shufps/iota_vhdl_pow/pcb/rev1.3/rev1.3.jpg

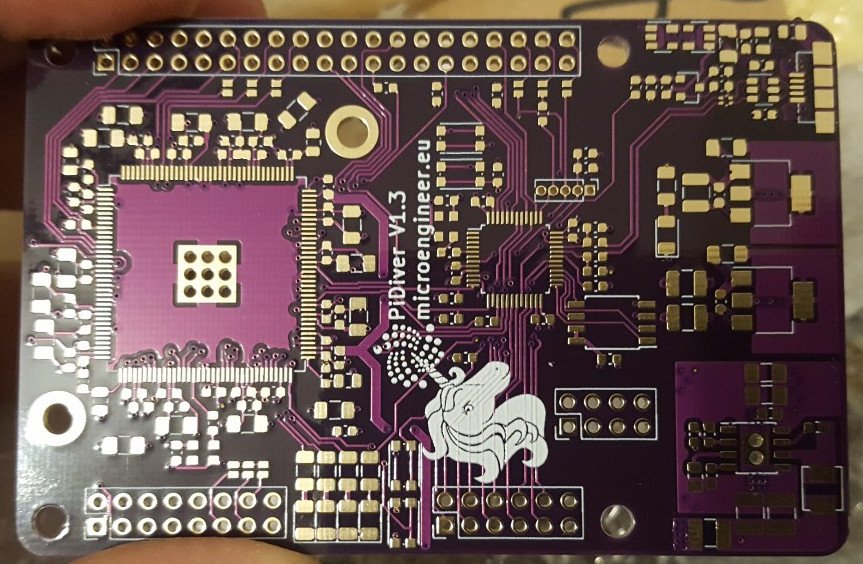
pcb/rev1.3/rev1.3.jpg
