shufps/iota_vhdl_pow/README.md

# IOTA VHDL PoW (Pearl Diver)

Project moved to:

https://gitlab.com/microengineer18/pidiver1.3/wikis/home
