shufps/iota_vhdl_pow/pcb/README.md

Files not suitable for machine assembly!
Board files are outdated ... New files with many improvements coming #soon
