shufps/iota_vhdl_pow/pcb/rev1.3/bom_mouser.xls

PIDIVER 1.3
Mouser-Nr. | Herst.- Nr. | Hersteller | Kunden-Teilenr | Beschreibung | RoHS | Lebenszyklus | Stückzahl | Preis (EUR) | Gesamtpreis: (EUR)
989-10CL025YE144I7G | 10CL025YE144I7G | Intel |  | FPGA – Universalschaltkreis | RoHS-konform | Neues Produkt | 1 | 23,21 € | 23,21 €
700-MAX40200AUK+T | MAX40200AUK+T | Maxim Integrated |  | Überwachungsschaltungen Current Sense/Ideal Diode | RoHS-konform | Neues Produkt | 2 | 0,553 € | 1,11 €
511-LD1117S33 | LD1117S33TR | STMicroelectronics |  | LDO Spannungs-Regulator 3.3V 0.8A Positive | RoHS-konform |  | 1 | 0,349 € | 0,35 €
755-BD9D321EFJ-E2 | BD9D321EFJ-E2 | ROHM Semiconductor |  | Schaltspannungsregler IC Pwr Swtch Reg Integrated FET | RoHS-konform |  | 1 | 0,621 € | 0,62 €
511-LDL1117S25R | LDL1117S25R | STMicroelectronics |  | LDO Spannungs-Regulator | RoHS-konform | Neues Produkt | 1 | 0,374 € | 0,37 €
511-STM32F302CCT6TR | STM32F302CCT6TR | STMicroelectronics |  | ARM Mikrocontroller - MCU Mainstream Mixed signals MCUs ARM Cortex-M4 core with DSP and FPU, 256 Kbytes Flash, 72 MHz CPU, MPU, 12-bit ADC 5 MSPS, PGA, comparators |  | Neues Produkt | 1 | 5,32 € | 5,32 €
511-USBLC6-2SC6Y | USBLC6-2SC6Y | STMicroelectronics |  | ESD-Entstörer/TVS-Dioden 2 Line 2.5pF 10nA USB 2.0 Automotive | RoHS-konform |  | 1 | 0,621 € | 0,62 €
611-KMR223GLFG | KMR223GLFG | C&K Switches |  | Sensorschalter Spst-No 200Gf Gw Smd | RoHS-konform |  | 4 | 0,561 € | 2,24 €
649-10104110-0001LF | 10104110-0001LF | FCI / Amphenol |  | USB-Stecker 5P Quick Connect Micro USB TypeB Rcpt | RoHS-konform |  | 1 | 0,646 € | 0,65 €
710-74279220181 | 74279220181 | Wurth Electronics |  | Ferritperlen WE-MPSB Bead 0805 100MHz 180Ohm 3100mA | RoHS-konform |  | 6 | 0,29 € | 1,74 €
81-DLP11SA900HL2L | DLP11SA900HL2L | Murata |  | Gleichtaktdrosseln / Filter 90Ohm 20% 100MHz | RoHS-konform |  | 1 | 0,468 € | 0,47 €
810-SPM4012T-2R2MT | SPM4012T-2R2M T | TDK |  | Festinduktivitäten 2.2uH 95mohms 3.3A +/-20% | RoHS-konform |  | 1 | 1,28 € | 1,28 €
581-KC3225A8.C3GE | KC3225A8.00000C3GE00 | Kyocera |  | Clock-Standardoszillatoren 8.00000MHZ 3.3V | RoHS-konform |  | 2 | 1,32 € | 2,64 €
579-25VF080B504IS2AE | SST25VF080B-50-4I-S2AE | Microchip |  | NOR-Flash 2.7V to 3.6V 8Mbit SPI Serial Flash | RoHS-konform |  | 1 | 0,876 € | 0,88 €
603-CC603MRX7R7BB104 | CC0603MRX7R7BB104 | Yageo |  | Kondensator aus mehreren Keramikschichten MLCC - SMD/SMT 100nF 16V X7R 20% | RoHS: Konform durch Ausnahmegenehmigung |  | 47 | 0,033 € | 1,55 €
710-885012206014 | 885012206014 | Wurth Electronics |  | Kondensator aus mehreren Keramikschichten MLCC - SMD/SMT WCAP-CSGP 0.01uF 0603 10% 10V MLCC | RoHS-konform |  | 1 | 0,04 € | 0,04 €
710-885012206086 | 885012206086 | Wurth Electronics |  | Kondensator aus mehreren Keramikschichten MLCC - SMD/SMT WCAP-CSGP 3300pF 0603 10% 50V MLCC | RoHS-konform |  | 1 | 0,04 € | 0,04 €
710-885012006021 | 885012006021 | Wurth Electronics |  | Kondensator aus mehreren Keramikschichten MLCC - SMD/SMT WCAP-CSGP 47pF 0603 5% 16V MLCC | RoHS-konform |  | 2 | 0,07 € | 0,14 €
81-GRM21BR61C105KA1K | GRM21BR61C105KA01K | Murata |  | Kondensator aus mehreren Keramikschichten MLCC - SMD/SMT | RoHS-konform |  | 1 | 0,145 € | 0,15 €
77-VJ1206G106KXYTBC | VJ1206G106KXYTW1BC | Vishay |  | Kondensator aus mehreren Keramikschichten MLCC - SMD/SMT 1206 10uF 6.3volts X5R 10% | RoHS-konform |  | 14 | 0,128 € | 1,79 €
963-TMK316BJ475ML-T | TMK316BJ475ML-T | Taiyo Yuden |  | Kondensator aus mehreren Keramikschichten MLCC - SMD/SMT FACTORY NOT ACCEPTING ORDERS | RoHS-konform |  | 2 | 0,247 € | 0,49 €
581-12064D476MAT2A | 12064D476MAT2A | AVX |  | Kondensator aus mehreren Keramikschichten MLCC - SMD/SMT FACTORY NOT ACCEPTING ORDERS | RoHS-konform |  | 4 | 0,748 € | 2,99 €
810-C3225X5R1A476M | C3225X5R1A476M250AC | TDK |  | Kondensator aus mehreren Keramikschichten MLCC - SMD/SMT 1210 10V 47uF X5R 20% T: 2.5mm | RoHS-konform |  | 5 | 1,07 € | 5,35 €
603-AC0603FR-0722RL | AC0603FR-0722RL | Yageo |  | Dickfilmwiderstände - SMD 1/10W 22ohm 1% AEC-Q200 | RoHS: Konform durch Ausnahmegenehmigung |  | 5 | 0,085 € | 0,43 €
603-RC0603FR-0733RL | RC0603FR-0733RL | Yageo |  | Dickfilmwiderstände - SMD 33 OHM 1% | RoHS-konform |  | 2 | 0,085 € | 0,17 €
603-RC0603FR-07100KL | RC0603FR-07100KL | Yageo |  | Dickfilmwiderstände - SMD 100K OHM 1% | RoHS-konform |  | 1 | 0,085 € | 0,09 €
756-GWCR0603-10KFT5 | GWCR0603-10KFT5 | TT Electronics |  | Dickfilmwiderstände - SMD 1/10W 10K Ohm 1% | RoHS-konform | Neues Produkt | 10 | 0,085 € | 0,85 €
603-RC0603FR-071K5L | RC0603FR-071K5L | Yageo |  | Dickfilmwiderstände - SMD 1.5K OHM 1% | RoHS-konform |  | 1 | 0,085 € | 0,09 €
279-CPF0603B12K7E1 | CPF0603B12K7E1 | TE Connectivity |  | Dünnfilmwiderstände - SMD CPF 0603 12K7 0.1% 25PPM 1K RL | RoHS-konform |  | 1 | 0,17 € | 0,17 €
279-CPF0603B22KE1 | CPF0603B22KE1 | TE Connectivity |  | Dünnfilmwiderstände - SMD CPF 0603 22K 0.1% 25PPM 1K RL | RoHS-konform |  | 1 | 0,264 € | 0,26 €
603-RT1206FRE07270RL | RT1206FRE07270RL | Yageo |  | Dünnfilmwiderstände - SMD 1/4W 270 ohm 1% 50ppm | RoHS: Konform durch Ausnahmegenehmigung |  | 5 | 0,162 € | 0,81 €
710-150120RS75000 | 150120RS75000 | Wurth Electronics |  | Standard-LEDs - SMD WL-SMCW SMDMono TpVw Waterclr 1206 Red | RoHS-konform |  | 5 | 0,19 € | 0,95 €
984-CPX02502-137C2R0 | ATS-CPX025025010-137-C2-R0 | Advanced Thermal Solutions |  | Wärmeableitungen PUSHPIN H/S BLUE 25X25X10.0mm | RoHS-konform | Neu bei Mouser | 1 | 2,98 € | 2,98 €
984-ATS-PP-01 | ATS-PP-01 | Advanced Thermal Solutions |  | Wärmeableitungen MUSIC WIRE COIL SPRING | RoHS-konform | Neu bei Mouser | 2 | 0,825 € | 1,65 €
984-ATS-PPS-02 | ATS-PPS-02 | Advanced Thermal Solutions |  | Wärmeableitungen MUSIC WIRE COIL SPRING | RoHS-konform | Neu bei Mouser | 2 | 0,17 € | 0,34 €
