shufps/iota_vhdl_pow/(threads)

Thread 3 (2018-09-17):

version confusion

gitrago, 2018-09-17:
Do the Gerber files in`iota_vhdl_pow/pcb/rev1.0/kicad/pearldiver/gerber/` correspond with the BOM in `iota_vhdl_pow/pcb/rev1.2/`?

Thread 4 (2018-09-18):

Follow-up to Q 'version confusion'

gitrago, 2018-09-18:
Do you plan to publish the gerbers for v1.2 and v1.3? If so, when? If not, then what is the point in publishing the BOMs?

shufps, 2018-09-18:
Gerbers for v1.3 will be published - but not now. Currently I'm hoping to get funded from the ecosystem which would allow me to manufactur and sell PiDivers. Not releasing the gerbers currently is to protect my work - I would like to get the chance to manufactur them before someone else uses my files. But I don't know (yet) when and if I it gets funded.

Released BOM-files are for people who want to assemble PiDivers by themselves. Some people got PCBs from me - for beta-testers so to say. :)

shufps, 2018-09-18:
By the way, rev1.0 still is supported and fully functional. It has some features less than newer revisions, but it can do PoW with Raspberry or USB.

Some changes:
rev1.1: another STM32 micro which has a default bootloader for flashing; Automatic switch of USB-power and GPIO-power was tested (but didn't work)
rev1.2: automatic switching works. It also got a pinheader for spare pins from the FPGA
rev1.3: default bootload is simpler to access with push-buttons. Additional pinheader for unused pins from the STM32.

But the PoW over Raspi or USB didn't change much - both work fine in rev1.0.
