shufps/iota_vhdl_pow/pcb/rev1.3/pearldiver-F.Fab.pdf

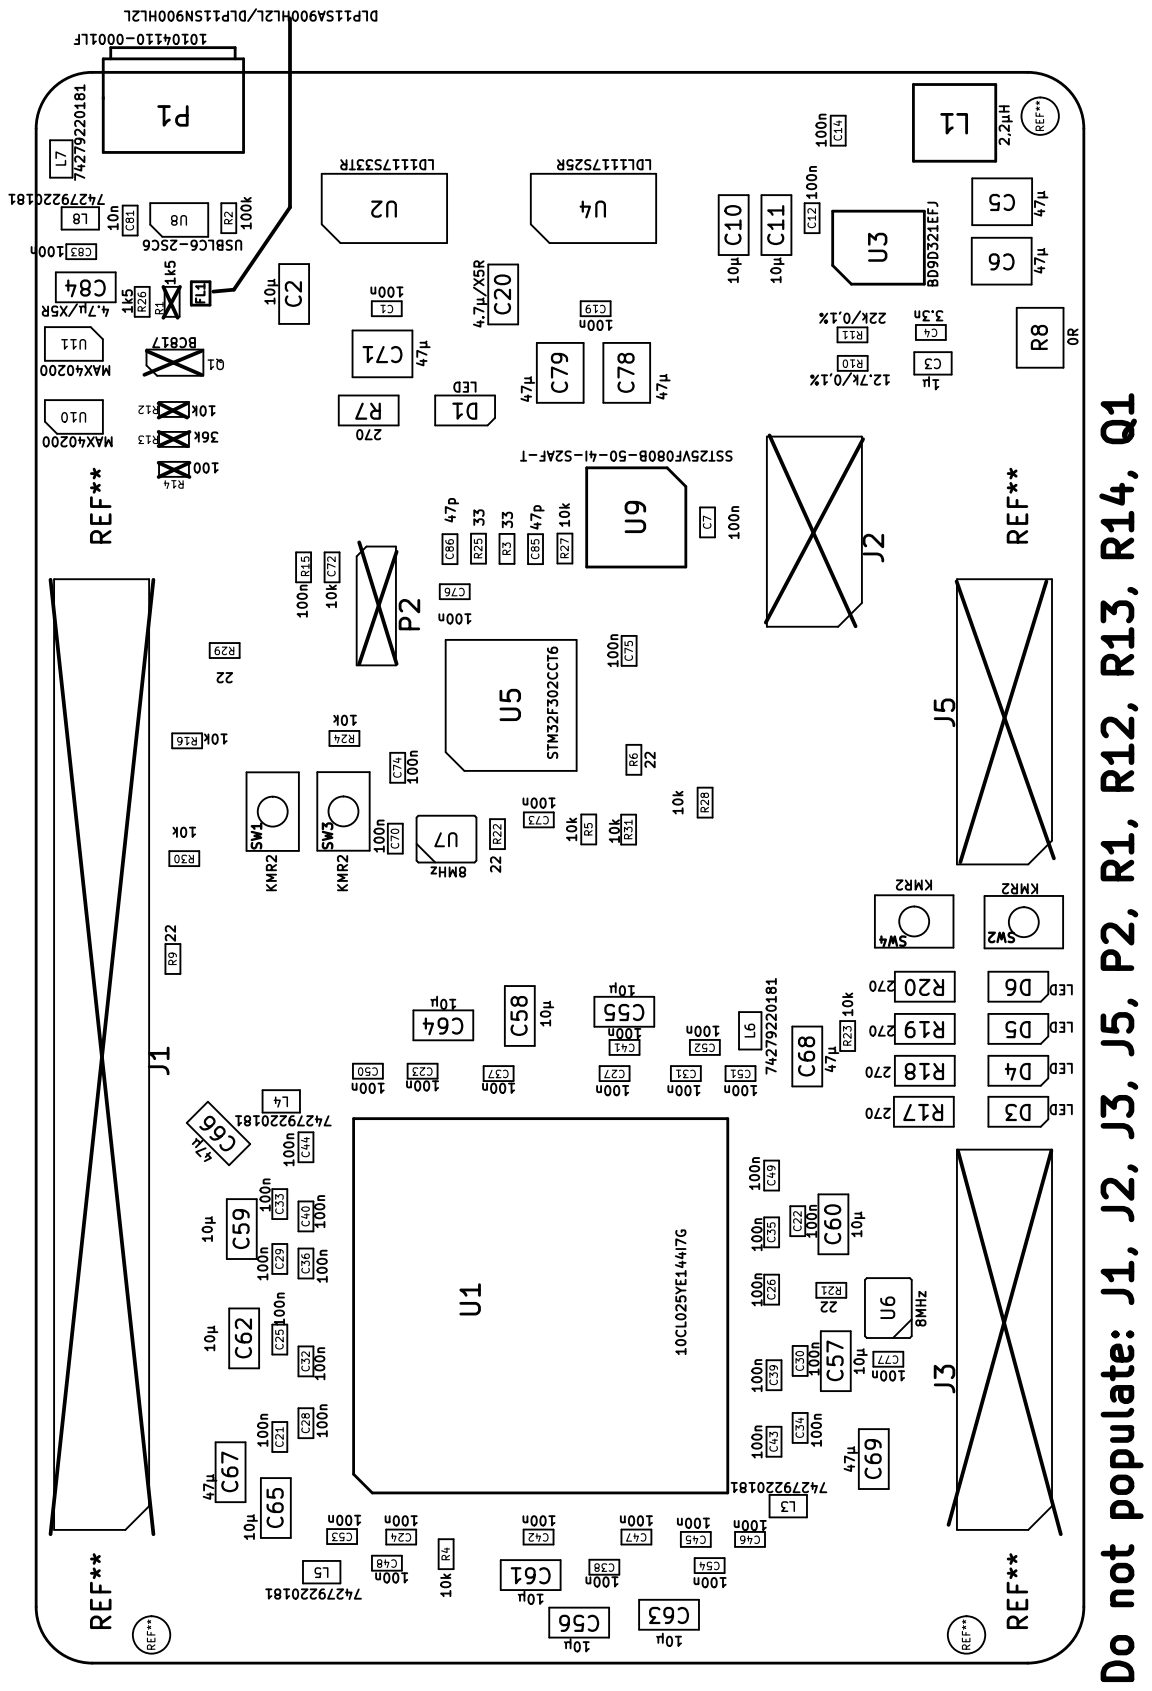
[picture p2: page 1]
