shufps/iota_vhdl_pow/pcb/rev1.0/pearldiver-front.pdf

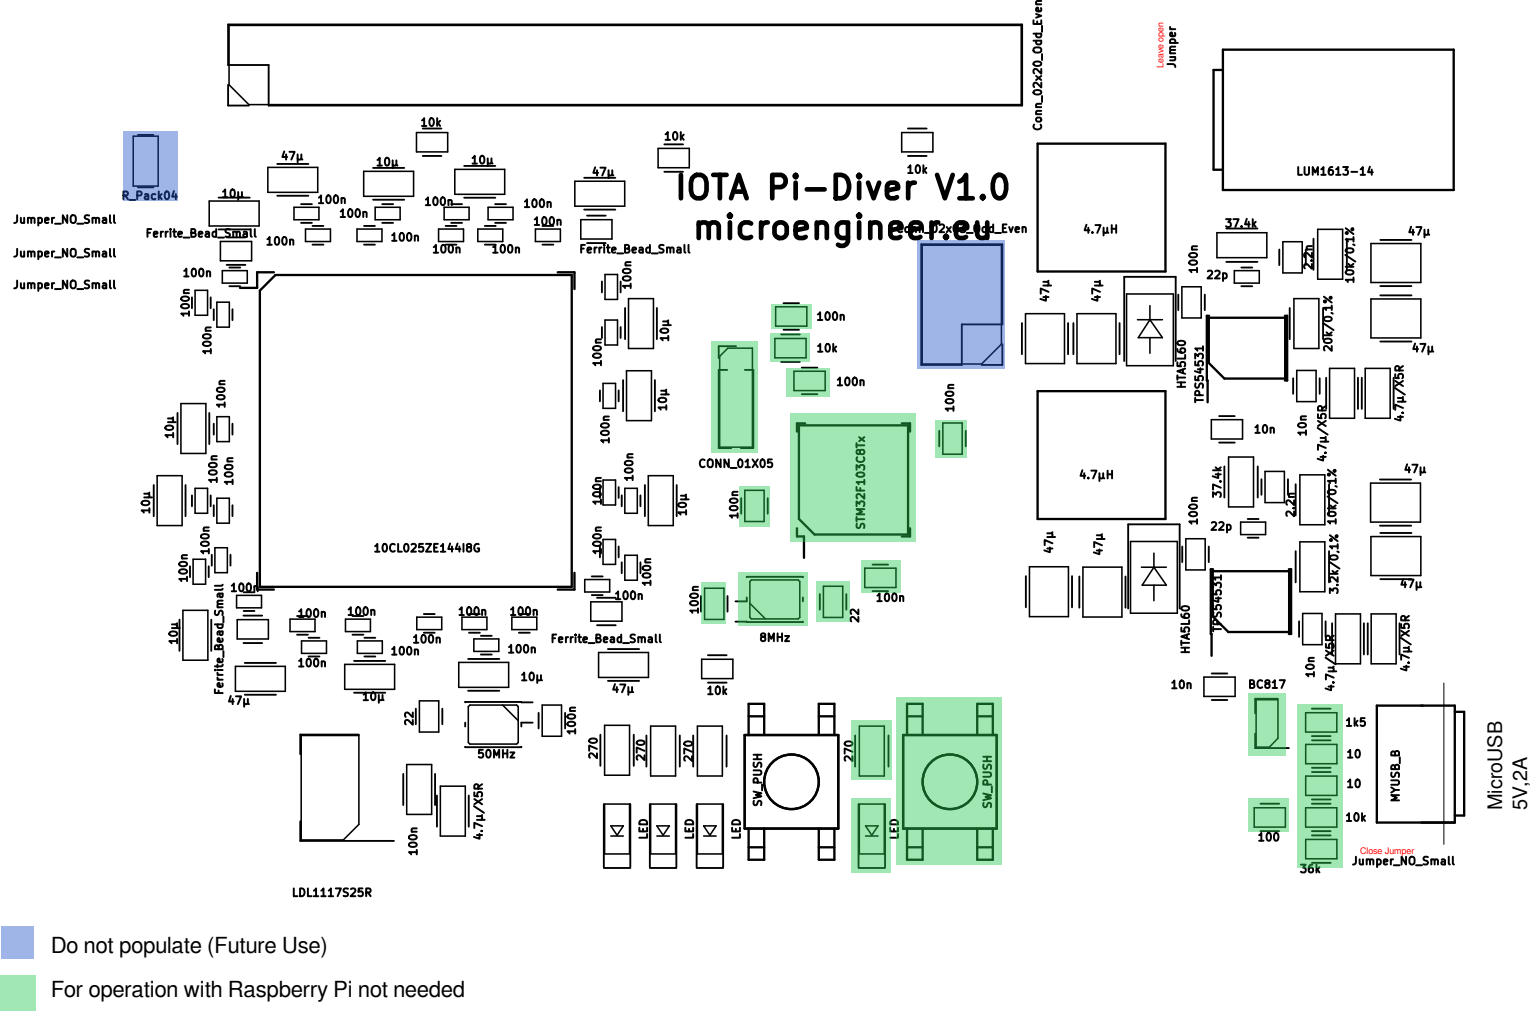
[picture p3: page 1]
Close Jumper; Leave open; MicroUSB

Do not populate (Future Use)
For operation with Raspberry Pi not needed
