shufps/iota_vhdl_pow/pcb/rev1.2/pidiver1.2.f.fab.pdf

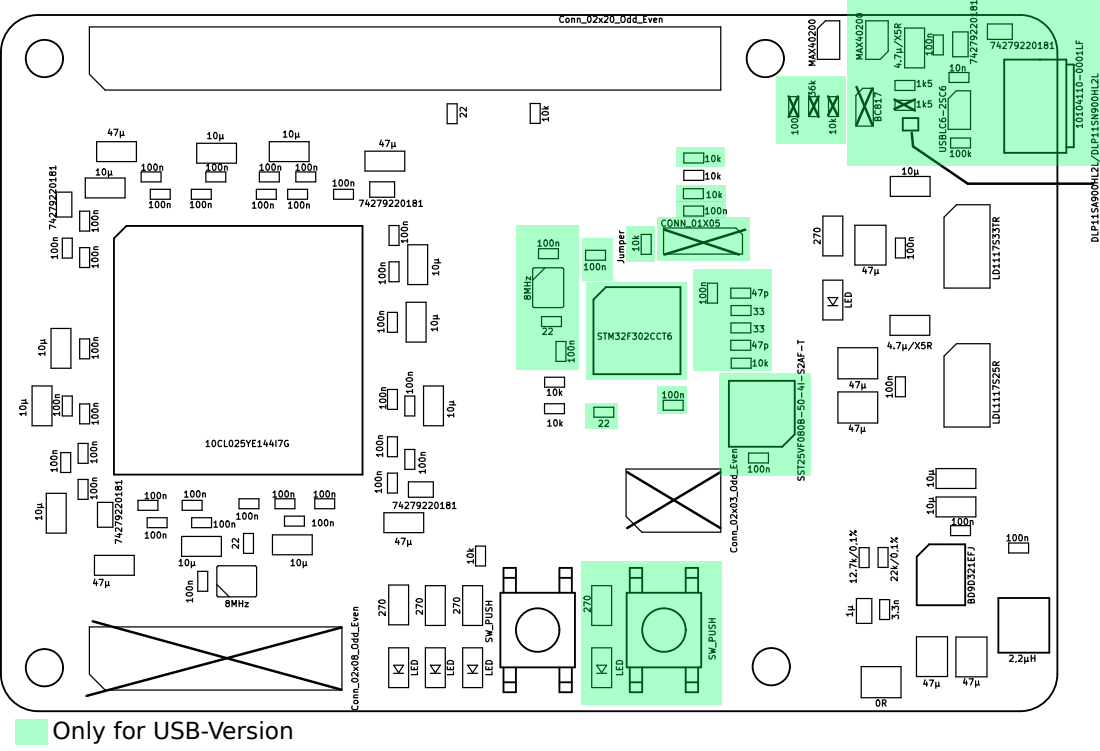
[picture p4: page 1]

Only for USB-Version
