shufps/iota_vhdl_pow/pcb/rev1.0/kicad/pearldiver/pearldiver.kicad_pcb

## KiCad design pcb/rev1.0/kicad/pearldiver/pearldiver.kicad_pcb (2019-02-22, an earlier design)

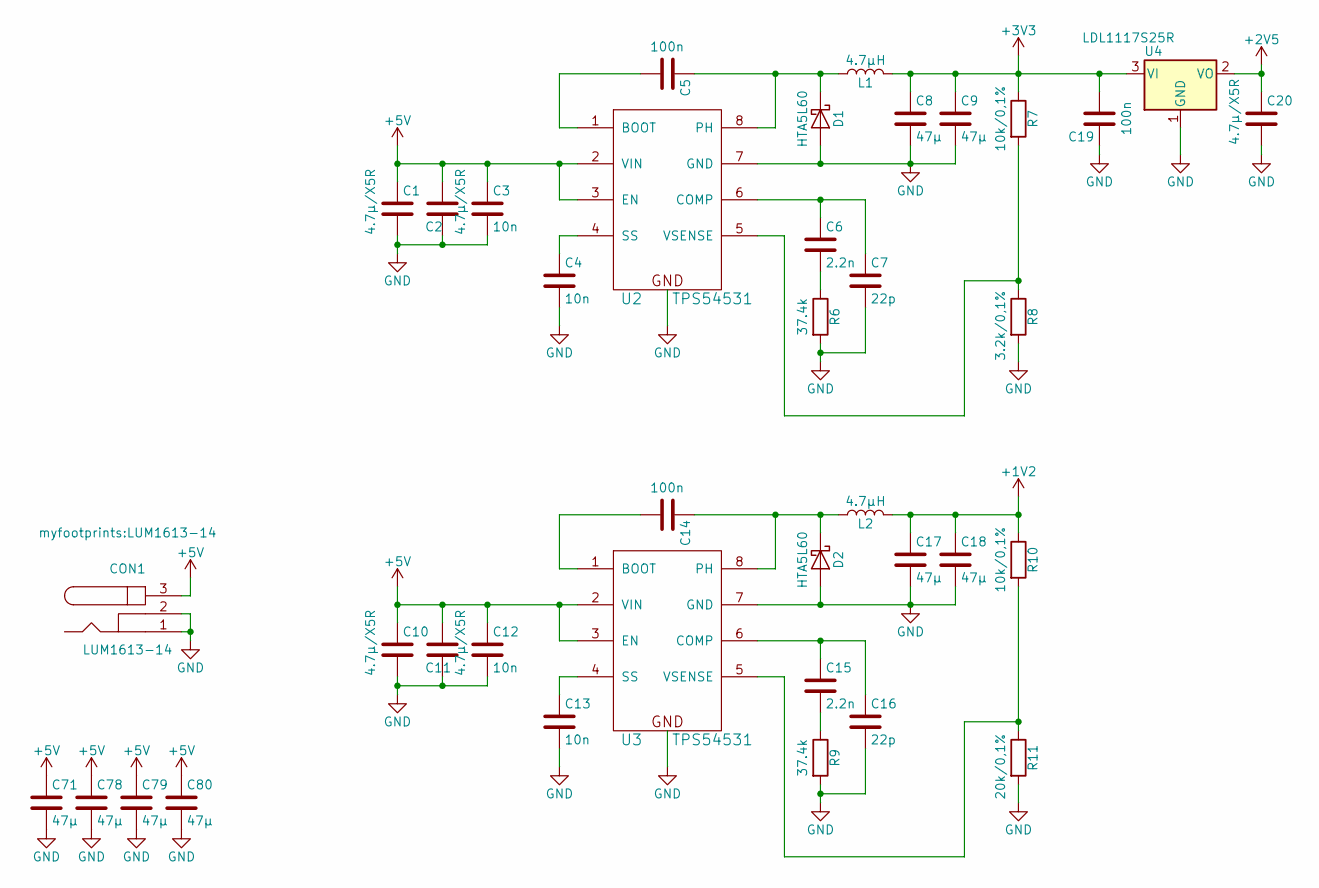
[picture p10: schematic power.sch]

Parts:
C1, C2, C10, C11, C20: 4.7µ/X5R; C_1206
C3, C4, C12, C13: 10n; C_0805
C5, C14: 100n; C_0805
C6, C15: 2.2n; C_0805
C7, C16: 22p; C_0603
C8, C9, C17, C18, C71, C78, C79, C80: 47µ; C_1210
C19: 100n; C_1206
CON1: LUM1613-14
D1, D2: HTA5L60; D_SMA
L1, L2: 4.7µH; IHLP-3232DZ-01
R6, R9: 37.4k; R_1206
R7, R10: 10k/0,1%; R_1206
R8: 3.2k/0,1%; R_1206
R11: 20k/0,1%; R_1206
U2, U3: TPS54531; SOIC-8-1EP_3.9x4.9mm_Pitch1.27mm
U4: LDL1117S25R; SOT-223-3_TabPin2

Connections:
+1V2: C17.1, C18.1, L2.2, R10.1; also elsewhere on the board
+2V5: C20.1, U4.2 (VO); also elsewhere on the board
+5V: C1.1, C2.1, C3.1, C10.1, C11.1, C12.1, C71.1, C78.1, C79.1, C80.1, CON1.3, U2.2 (VIN), U2.3 (EN), U3.2 (VIN), U3.3 (EN); also elsewhere on the board
GND: C1.2, C2.2, C3.2, C4.2, C7.2, C8.2, C9.2, C10.2, C11.2, C12.2, C13.2, C16.2, C17.2, C18.2, C19.1, C20.2, C71.2, C78.2, C79.2, C80.2, CON1.1, CON1.2, D1.2 (A), D2.2 (A), R6.2, R8.2, R9.2, R11.2, U2.7 (GND), U2.9 (GND), U3.7 (GND), U3.9 (GND), U4.1 (GND); also elsewhere on the board
unnamed: C4.1, U2.4 (SS)
unnamed: C5.1, D1.1 (K), L1.1, U2.8 (PH)
unnamed: C5.2, U2.1 (BOOT)
unnamed: C6.1, C7.1, U2.6 (COMP)
unnamed: C6.2, R6.1
unnamed: C13.1, U3.4 (SS)
unnamed: C14.1, D2.1 (K), L2.1, U3.8 (PH)
unnamed: C14.2, U3.1 (BOOT)
unnamed: C15.1, C16.1, U3.6 (COMP)
unnamed: C15.2, R9.1
unnamed: R7.2, R8.1, U2.5 (VSENSE)
unnamed: R10.2, R11.1, U3.5 (VSENSE)

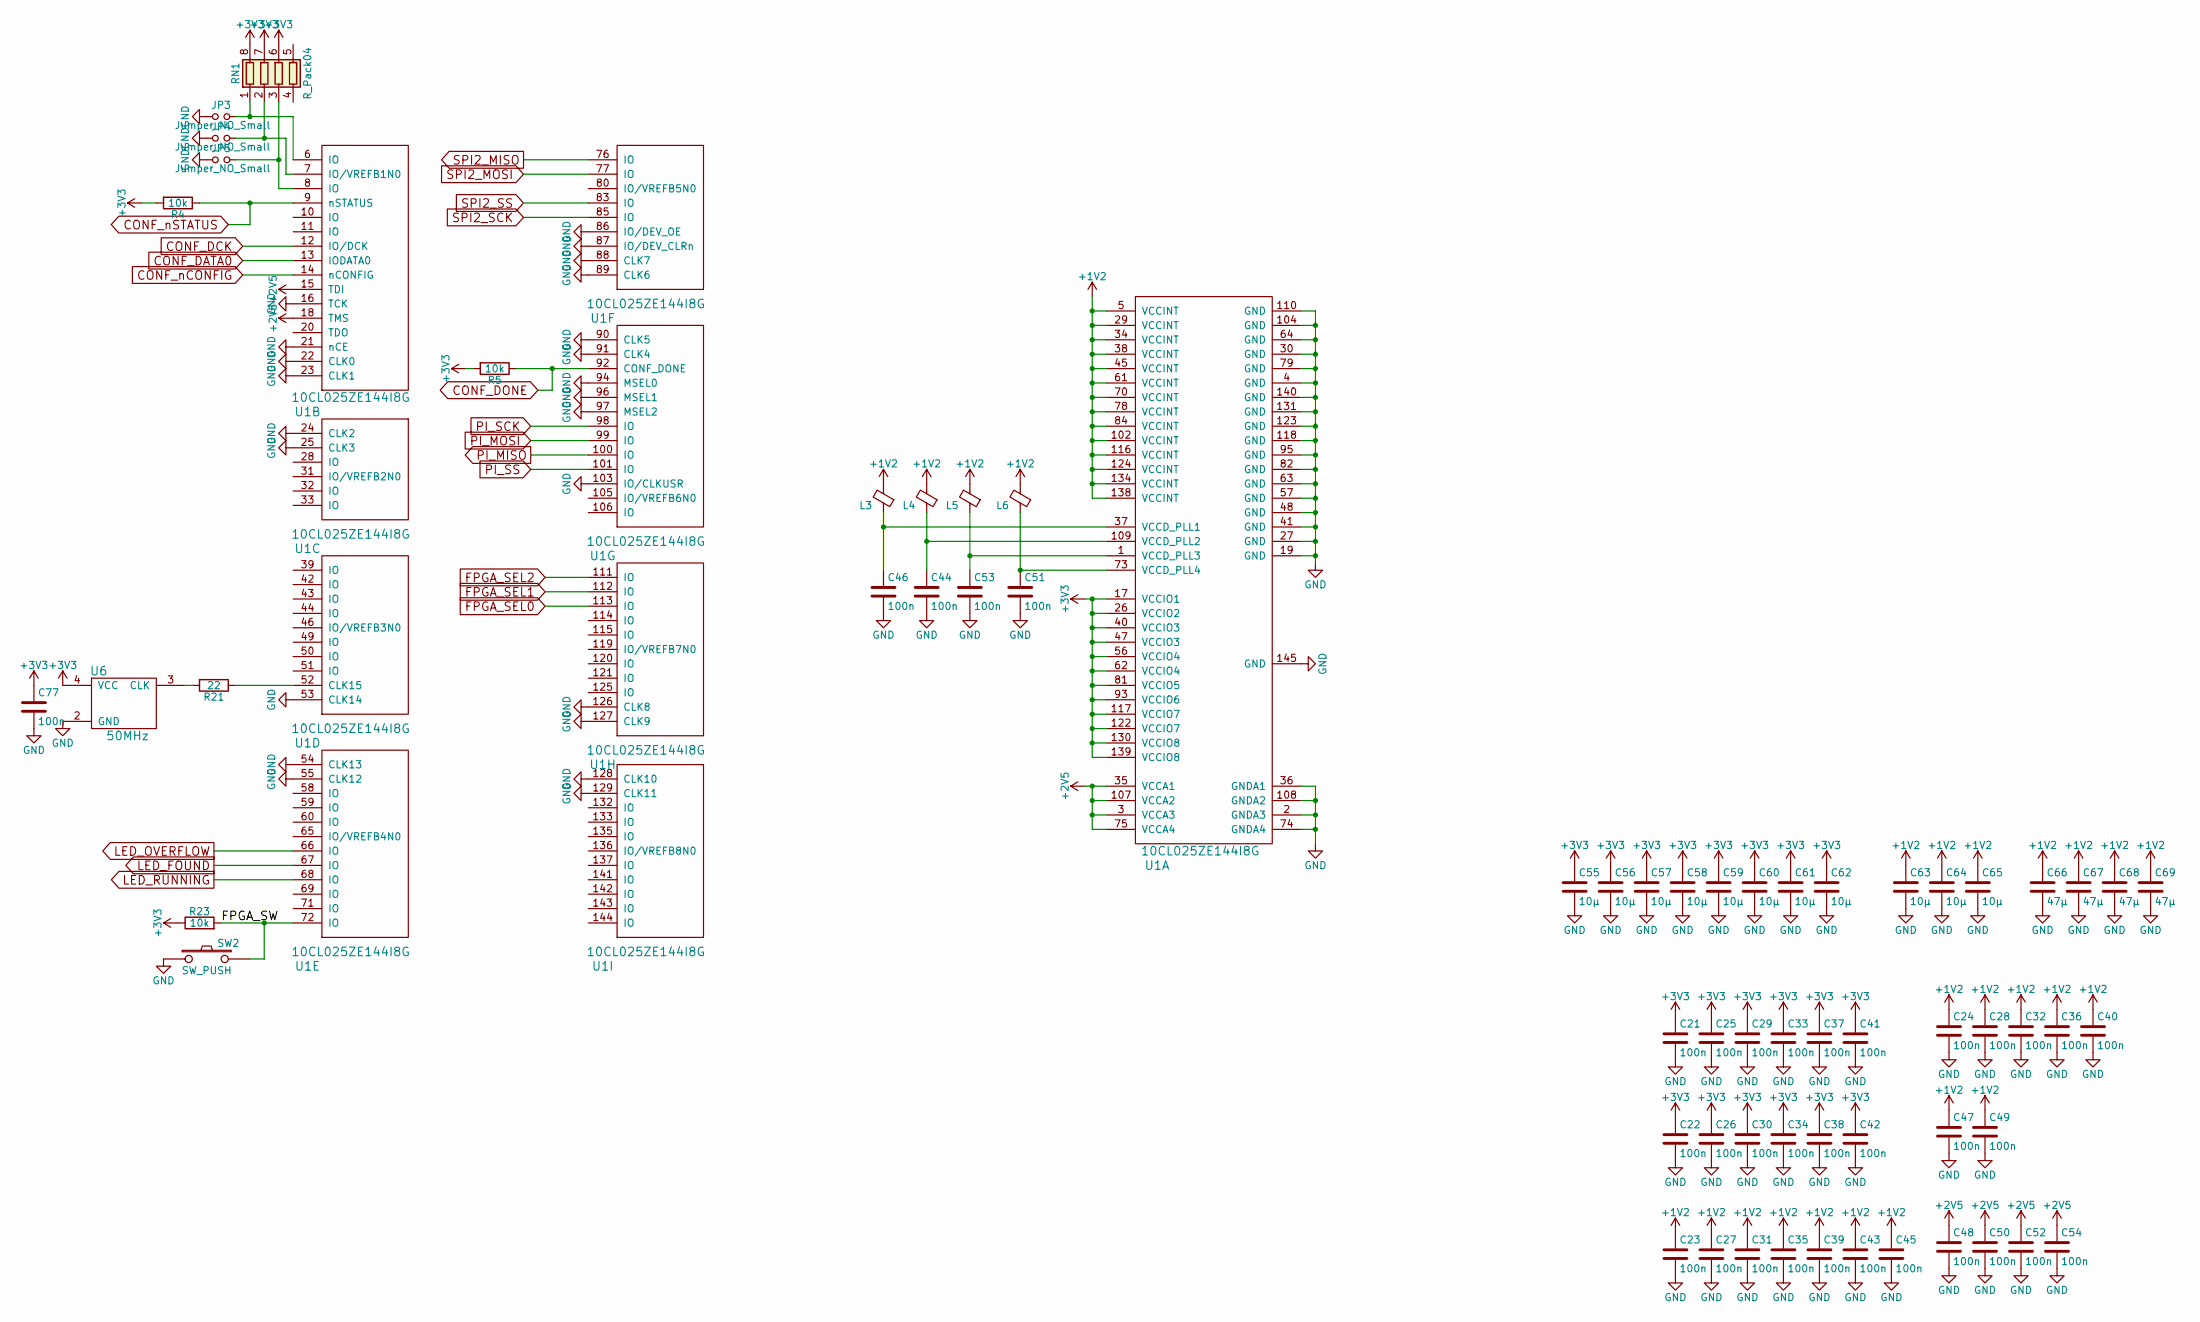
[picture p11: schematic fpga.sch]

Parts:
C21, C22, C23, C24, C25, C26, C27, C28, C29, C30, C31, C32, C33, C34, C35, C36, C37, C38, C39, C40, C41, C42, C43, C44, C45, C46, C47, C48, C49, C50, C51, C52, C53, C54: 100n; C_0603
C55, C56, C57, C58, C59, C60, C61, C62, C63, C64, C65: 10µ; C_1206
C66, C67, C68, C69: 47µ; C_1206
C77: 100n; C_0805
JP3, JP4, JP5: Jumper_NO_Small; SOLDERJMP
L3, L4, L5, L6: Ferrite_Bead_Small; R_0805
R4, R5, R23: 10k; R_0805
R21: 22; C_0805
RN1: R_Pack04; R_Array_Convex_4x0603
SW2: SW_PUSH; KURZHUB_SMD
U1: 10CL025ZE144I8G; EQFP-144_20x20mm_Pitch0.5mm
U6: 50MHz; Oscillator_SMD_EuroQuartz_XO32-4pin_3.2x2.5mm_HandSoldering

Connections:
+1V2: C23.1, C24.1, C27.1, C28.1, C31.1, C32.1, C35.1, C36.1, C39.1, C40.1, C43.1, C45.1, C47.1, C49.1, C63.1, C64.1, C65.1, C66.1, C67.1, C68.1, C69.1, L3.2, L4.2, L5.2, L6.2, U1.5 (VCCINT), U1.29 (VCCINT), U1.34 (VCCINT), U1.38 (VCCINT), U1.45 (VCCINT), U1.61 (VCCINT), U1.70 (VCCINT), U1.78 (VCCINT), U1.84 (VCCINT), U1.102 (VCCINT), U1.116 (VCCINT), U1.124 (VCCINT), U1.134 (VCCINT), U1.138 (VCCINT); also elsewhere on the board
+2V5: C48.1, C50.1, C52.1, C54.1, U1.3 (VCCA3), U1.15 (TDI), U1.18 (TMS), U1.35 (VCCA1), U1.75 (VCCA4), U1.107 (VCCA2); also elsewhere on the board
/fpga/FPGA_SW: R23.2, SW2.2, U1.72 (IO)
CONF_DATA0: U1.13 (IODATA0); also elsewhere on the board
CONF_DCK: U1.12 (IO/DCK); also elsewhere on the board
CONF_DONE: R5.1, U1.92 (CONF_DONE); also elsewhere on the board
CONF_nCONFIG: U1.14 (nCONFIG); also elsewhere on the board
CONF_nSTATUS: R4.1, U1.9 (nSTATUS); also elsewhere on the board
FPGA_SEL0: U1.113 (IO); also elsewhere on the board
FPGA_SEL1: U1.112 (IO); also elsewhere on the board
FPGA_SEL2: U1.111 (IO); also elsewhere on the board
GND: C21.2, C22.2, C23.2, C24.2, C25.2, C26.2, C27.2, C28.2, C29.2, C30.2, C31.2, C32.2, C33.2, C34.2, C35.2, C36.2, C37.2, C38.2, C39.2, C40.2, C41.2, C42.2, C43.2, C44.2, C45.2, C46.2, C47.2, C48.2, C49.2, C50.2, C51.2, C52.2, C53.2, C54.2, C55.2, C56.2, C57.2, C58.2, C59.2, C60.2, C61.2, C62.2, C63.2, C64.2, C65.2, C66.2, C67.2, C68.2, C69.2, C77.2, JP3.1, JP4.1, JP5.1, SW2.1, U1.2 (GNDA3), U1.4 (GND), U1.16 (TCK), U1.19 (GND), U1.21 (nCE), U1.22 (CLK0), U1.23 (CLK1), U1.24 (CLK2), U1.25 (CLK3), U1.27 (GND), U1.30 (GND), U1.36 (GNDA1), U1.41 (GND), U1.48 (GND), U1.53 (CLK14), U1.54 (CLK13), U1.55 (CLK12), U1.57 (GND), U1.63 (GND), U1.64 (GND), U1.74 (GNDA4), U1.79 (GND), U1.82 (GND), U1.86 (IO/DEV_OE), U1.87 (IO/DEV_CLRn), U1.88 (CLK7), U1.89 (CLK6), U1.90 (CLK5), U1.91 (CLK4), U1.94 (MSEL0), U1.95 (GND), U1.96 (MSEL1), U1.97 (MSEL2), U1.103 (IO/CLKUSR), U1.104 (GND), U1.108 (GNDA2), U1.110 (GND), U1.118 (GND), U1.123 (GND), U1.126 (CLK8), U1.127 (CLK9), U1.128 (CLK10), U1.129 (CLK11), U1.131 (GND), U1.140 (GND), U1.145 (GND), U6.2 (GND); also elsewhere on the board
LED_FOUND: U1.67 (IO); also elsewhere on the board
LED_OVERFLOW: U1.66 (IO); also elsewhere on the board
LED_RUNNING: U1.68 (IO); also elsewhere on the board
unnamed: C44.1, L4.1, U1.109 (VCCD_PLL2)
unnamed: C46.1, L3.1, U1.37 (VCCD_PLL1)
unnamed: C51.1, L6.1, U1.73 (VCCD_PLL4)
unnamed: C53.1, L5.1, U1.1 (VCCD_PLL3)
unnamed: JP3.2, RN1.1 (R1.1), U1.6 (IO)
unnamed: JP4.2, RN1.2 (R2.1), U1.7 (IO/VREFB1N0)
unnamed: JP5.2, RN1.3 (R3.1), U1.8 (IO)
unnamed: R21.1, U1.52 (CLK15)
unnamed: R21.2, U6.3 (CLK)
PI_MISO: U1.100 (IO); also elsewhere on the board
PI_MOSI: U1.99 (IO); also elsewhere on the board
PI_SCK: U1.98 (IO); also elsewhere on the board
PI_SS: U1.101 (IO); also elsewhere on the board
SPI2_MISO: U1.76 (IO); also elsewhere on the board
SPI2_MOSI: U1.77 (IO); also elsewhere on the board
SPI2_SCK: U1.85 (IO); also elsewhere on the board
SPI2_SS: U1.83 (IO); also elsewhere on the board

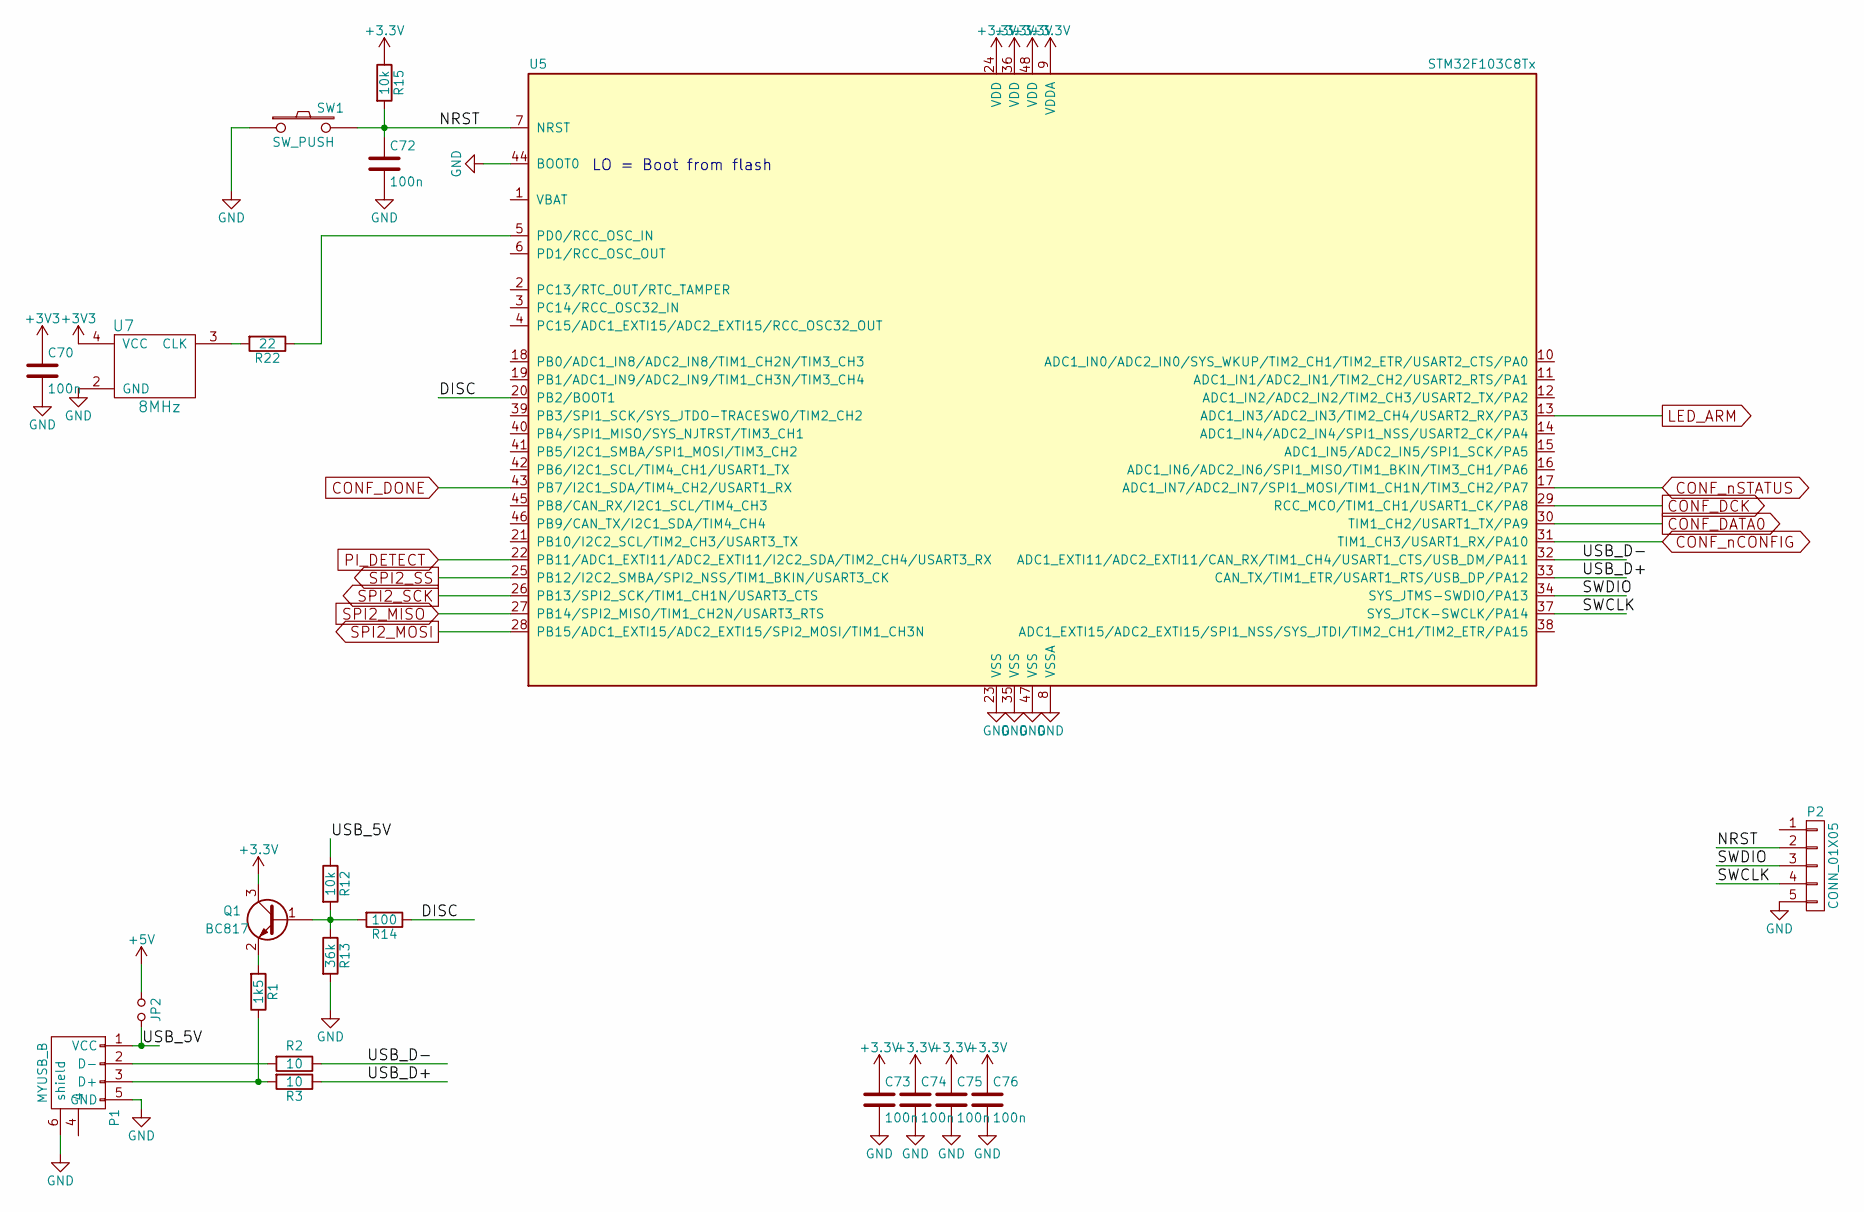
[picture p12: schematic arm7.sch]

Parts:
C70, C72, C73, C74, C75, C76: 100n; C_0805
JP2: Jumper_NO_Small; SOLDERJMP
P1: MYUSB_B; MICROUSBB
P2: CONN_01X05; Pin_Header_Straight_1x05_Pitch1.27mm
Q1: BC817; SOT-23
R1: 1k5; R_0805
R2, R3: 10; R_0805
R12, R15: 10k; R_0805
R13: 36k; R_0805
R14: 100; R_0805
R22: 22; C_0805
SW1: SW_PUSH; KURZHUB_SMD
U5: STM32F103C8Tx; LQFP-48_7x7mm_Pitch0.5mm
U7: 8MHz; Oscillator_SMD_EuroQuartz_XO32-4pin_3.2x2.5mm_HandSoldering

Connections:
+5V: JP2.1; also elsewhere on the board
/arm7/DISC: R14.1, U5.20 (PB2/BOOT1)
/arm7/NRST: C72.1, P2.2, R15.2, SW1.2, U5.7 (NRST)
/arm7/SWCLK: P2.4, U5.37 (SYS_JTCK-SWCLK/PA14)
/arm7/SWDIO: P2.3, U5.34 (SYS_JTMS-SWDIO/PA13)
/arm7/USB_5V: JP2.2, P1.1 (VCC), R12.1
/arm7/USB_D+: R3.1, U5.33 (CAN_TX/TIM1_ETR/USART1_RTS/USB_DP/PA12)
/arm7/USB_D-: R2.1, U5.32 (ADC1_EXTI11/ADC2_EXTI11/CAN_RX/TIM1_CH4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)
CONF_DATA0: U5.30 (TIM1_CH2/USART1_TX/PA9); also elsewhere on the board
CONF_DCK: U5.29 (RCC_MCO/TIM1_CH1/USART1_CK/PA8); also elsewhere on the board
CONF_DONE: U5.43 (PB7/I2C1_SDA/TIM4_CH2/USART1_RX); also elsewhere on the board
CONF_nCONFIG: U5.31 (TIM1_CH3/USART1_RX/PA10); also elsewhere on the board
CONF_nSTATUS: U5.17 (ADC1_IN7/ADC2_IN7/SPI1_MOSI/TIM1_CH1N/T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); also elsewhere on the board
GND: C70.2, C72.2, C73.2, C74.2, C75.2, C76.2, P1.5 (GND), P1.6 (shield), P2.5, R13.2, SW1.1, U5.8 (VSSA), U5.23 (VSS), U5.35 (VSS), U5.44 (BOOT0), U5.47 (VSS), U7.2 (GND); also elsewhere on the board
LED_ARM: U5.13 (ADC1_IN3/ADC2_IN3/TIM2_CH4/USART2_RX/PA3); also elsewhere on the board
unnamed: P1.2 (D-), R2.2
unnamed: P1.3 (D+), R1.1, R3.2
unnamed: Q1.1 (B), R12.2, R13.1, R14.2
unnamed: Q1.2 (E), R1.2
unnamed: R22.1, U5.5 (PD0/RCC_OSC_IN)
unnamed: R22.2, U7.3 (CLK)
PI_DETECT: U5.22 (PB11/ADC1_EXTI11/ADC2_EXTI11/I2C2_SDA/T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); also elsewhere on the board
SPI2_MISO: U5.27 (PB14/SPI2_MISO/TIM1_CH2N/USART3_RTS); also elsewhere on the board
SPI2_MOSI: U5.28 (PB15/ADC1_EXTI15/ADC2_EXTI15/SPI2_MOSI/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); also elsewhere on the board
SPI2_SCK: U5.26 (PB13/SPI2_SCK/TIM1_CH1N/USART3_CTS); also elsewhere on the board
SPI2_SS: U5.25 (PB12/I2C2_SMBA/SPI2_NSS/TIM1_BKIN/USART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); also elsewhere on the board

Notes on the sheet:
LO = Boot from flash

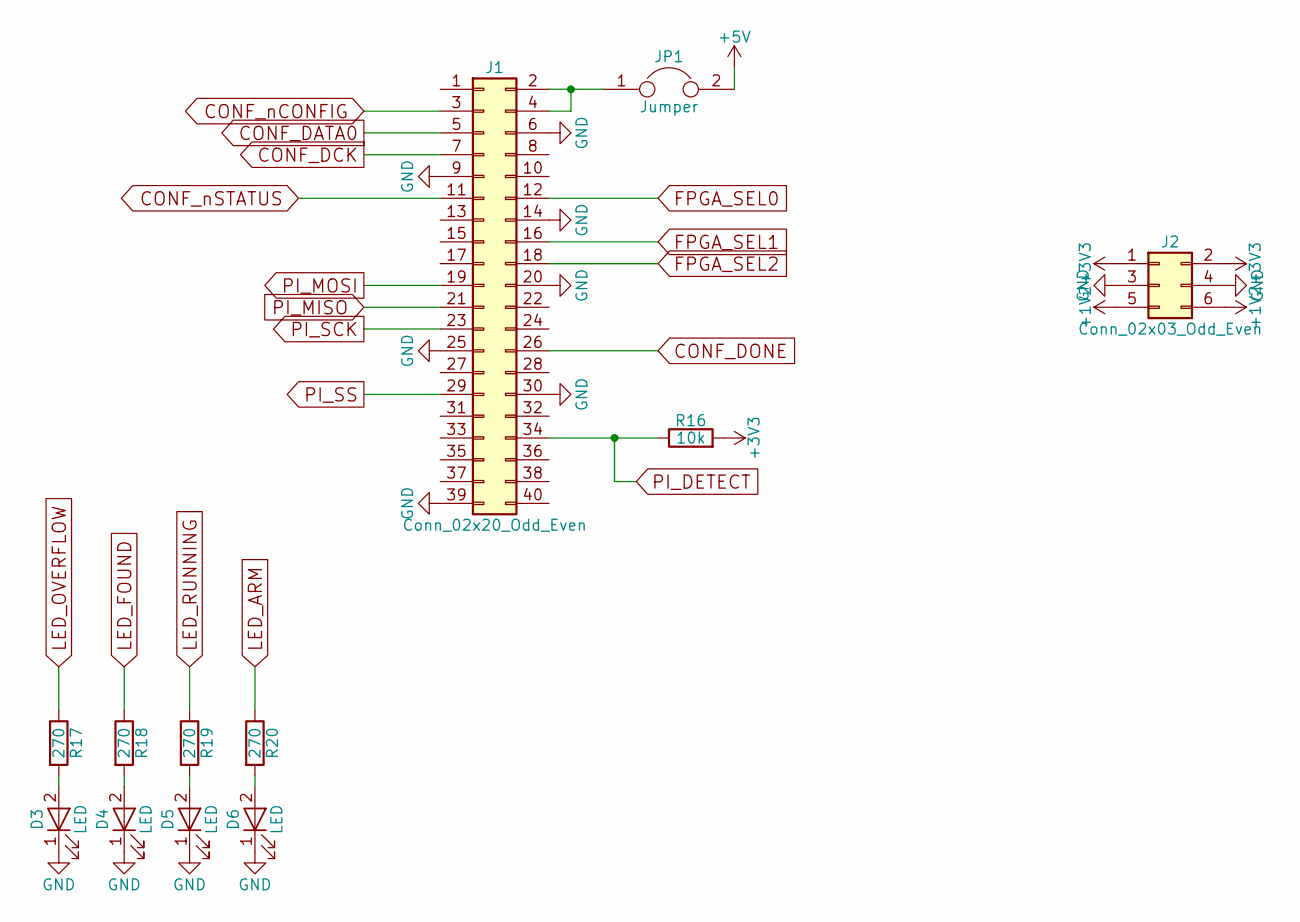
[picture p13: schematic connectors.sch]

Parts:
D3, D4, D5, D6: LED; LED_1206
J1: Conn_02x20_Odd_Even; Pin_Header_Straight_2x20_Pitch2.54mm
J2: Conn_02x03_Odd_Even; Pin_Header_Straight_2x03_Pitch2.54mm
JP1: Jumper; SOLDERJMP
R16: 10k; R_0805
R17, R18, R19, R20: 270; R_1206

Connections:
+1V2: J2.5, J2.6; also elsewhere on the board
+5V: JP1.2; also elsewhere on the board
CONF_DATA0: J1.5; also elsewhere on the board
CONF_DCK: J1.7; also elsewhere on the board
CONF_DONE: J1.26; also elsewhere on the board
CONF_nCONFIG: J1.3; also elsewhere on the board
CONF_nSTATUS: J1.11; also elsewhere on the board
FPGA_SEL0: J1.12; also elsewhere on the board
FPGA_SEL1: J1.16; also elsewhere on the board
FPGA_SEL2: J1.18; also elsewhere on the board
GND: D3.1 (K), D4.1 (K), D5.1 (K), D6.1 (K), J1.6, J1.9, J1.14, J1.20, J1.25, J1.30, J1.39, J2.3, J2.4; also elsewhere on the board
LED_ARM: R20.1; also elsewhere on the board
LED_FOUND: R18.1; also elsewhere on the board
LED_OVERFLOW: R17.1; also elsewhere on the board
LED_RUNNING: R19.1; also elsewhere on the board
unnamed: D3.2 (A), R17.2
unnamed: D4.2 (A), R18.2
unnamed: D5.2 (A), R19.2
unnamed: D6.2 (A), R20.2
unnamed: J1.2, J1.4, JP1.1
PI_DETECT: J1.34, R16.1; also elsewhere on the board
PI_MISO: J1.21; also elsewhere on the board
PI_MOSI: J1.19; also elsewhere on the board
PI_SCK: J1.23; also elsewhere on the board
PI_SS: J1.29; also elsewhere on the board

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
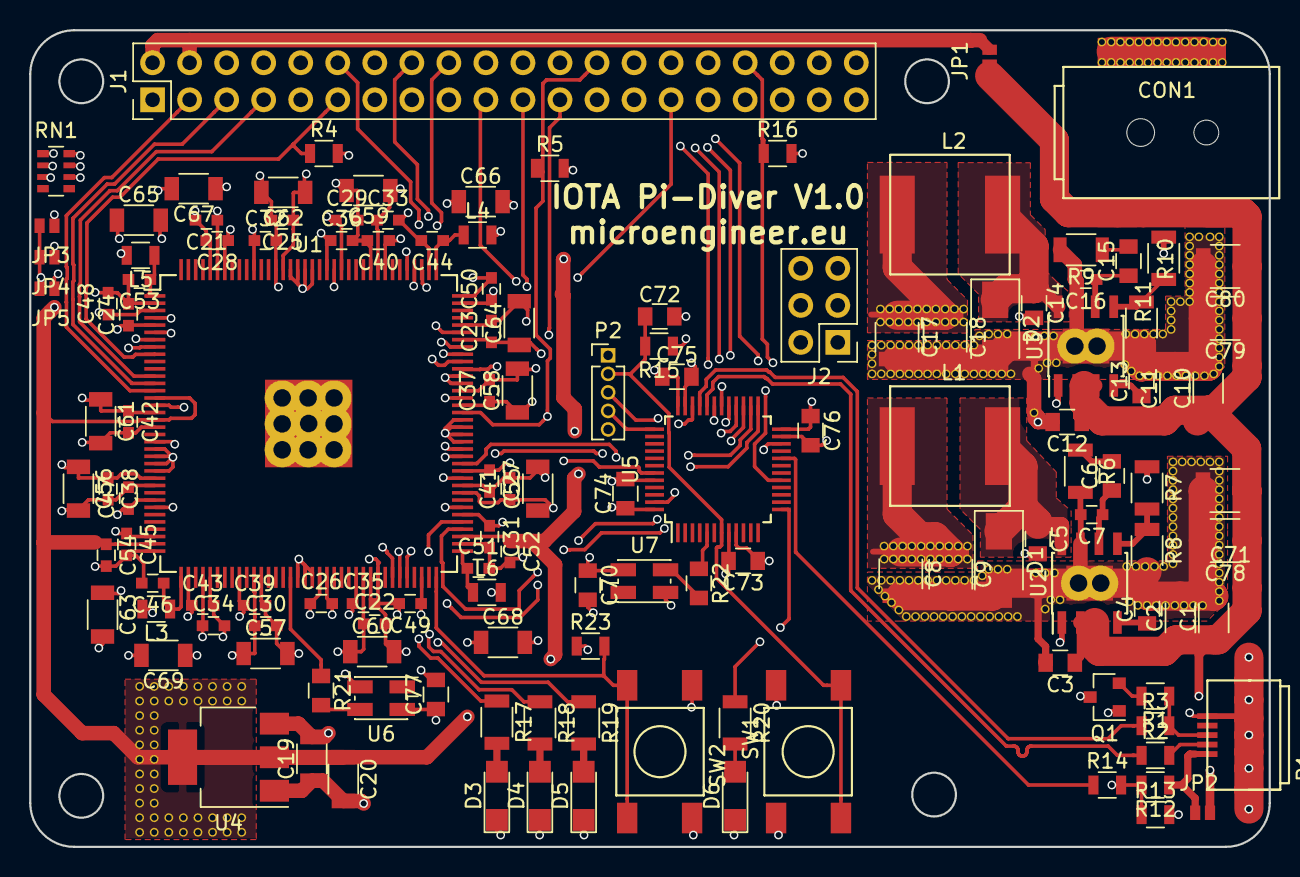
[picture p14: board pearldiver.kicad_pcb from above]

Board: 4 copper layers, 85.0 x 56.0 mm, 136 parts (0 on the bottom side), 66 nets.
